normanalie/vathult3000/hardware/electronic/InputBoard/BlocDiagram_Input.png

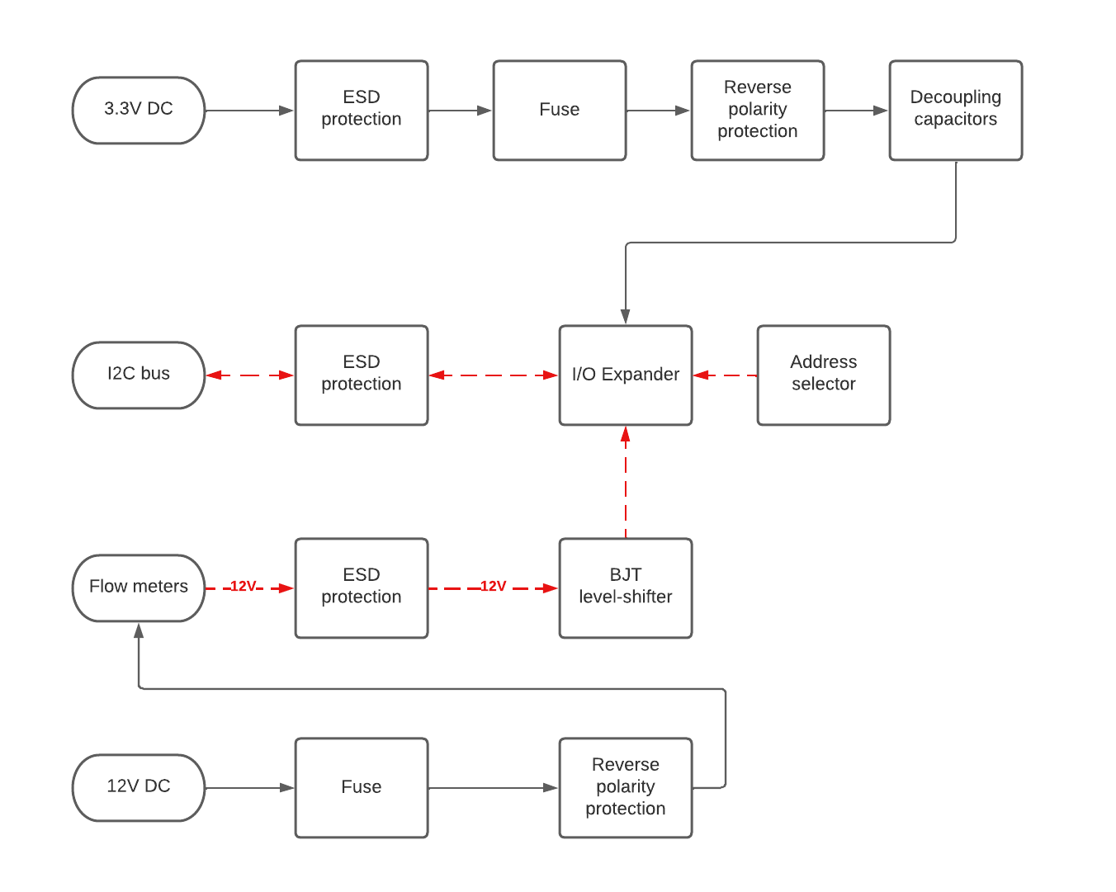
hardware/electronic/InputBoard/BlocDiagram_Input.png
