normanalie/vathult3000/hardware/electronic/InputBoard/render_2D.PNG

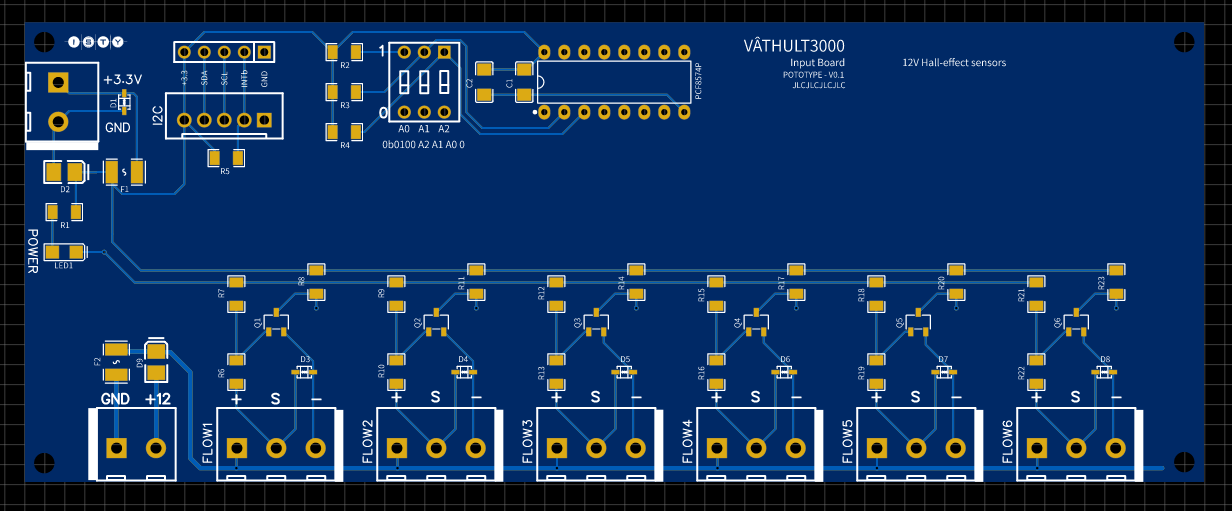
hardware/electronic/InputBoard/render_2D.PNG
