normanalie/vathult3000/hardware/electronic/InputBoard/render_3D.PNG

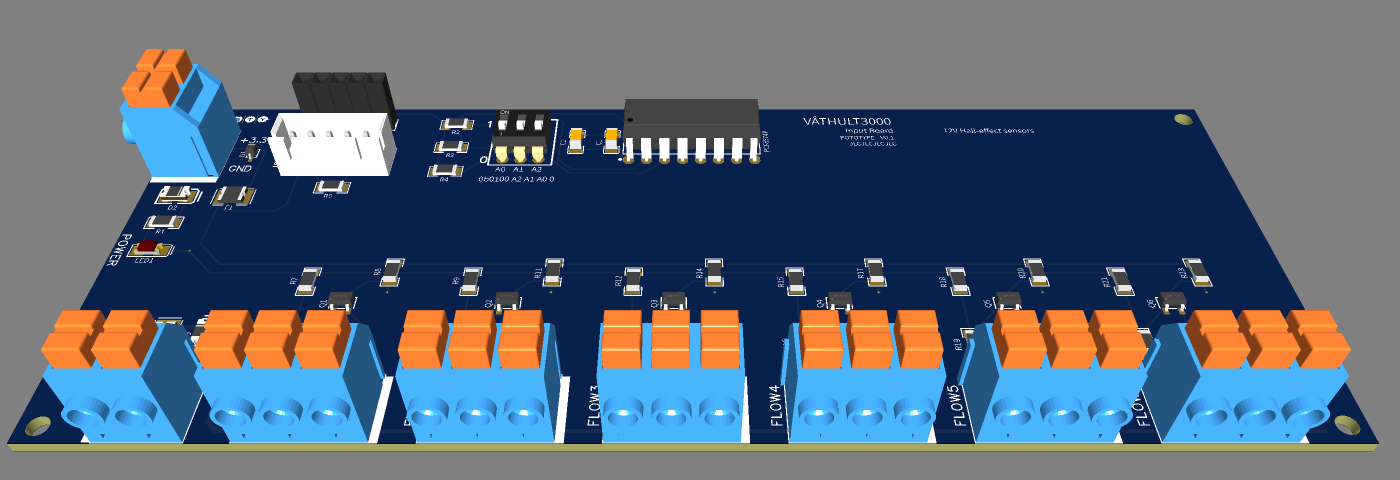
hardware/electronic/InputBoard/render_3D.PNG
