normanalie/vathult3000/hardware/electronic/InterfaceBoard/BlocDiagram_Interface.png

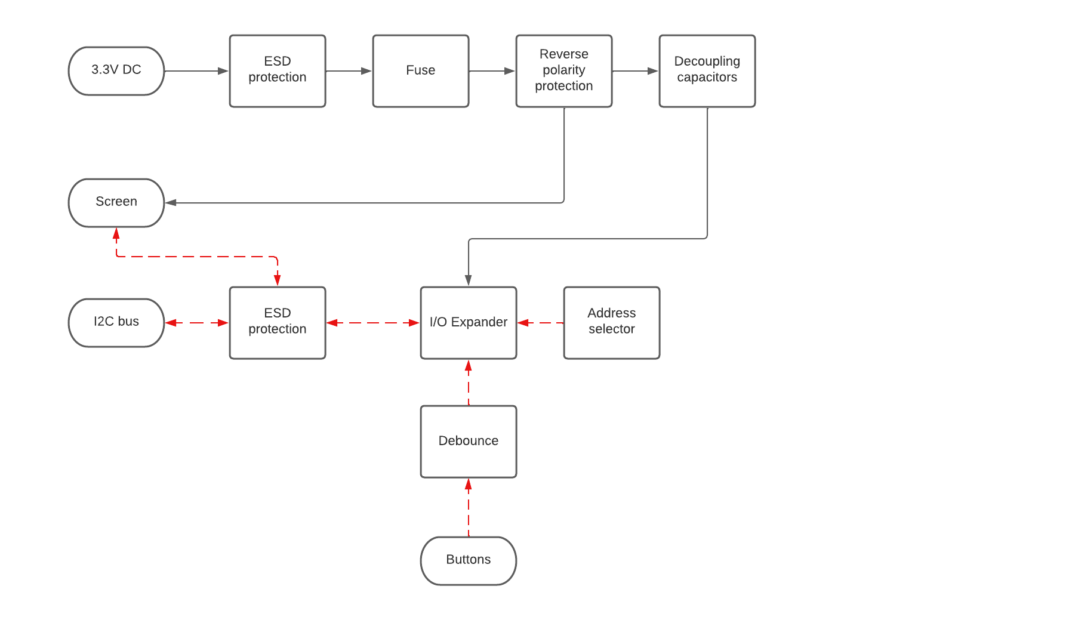
hardware/electronic/InterfaceBoard/BlocDiagram_Interface.png
