normanalie/vathult3000/hardware/electronic/InterfaceBoard/render_2D.PNG

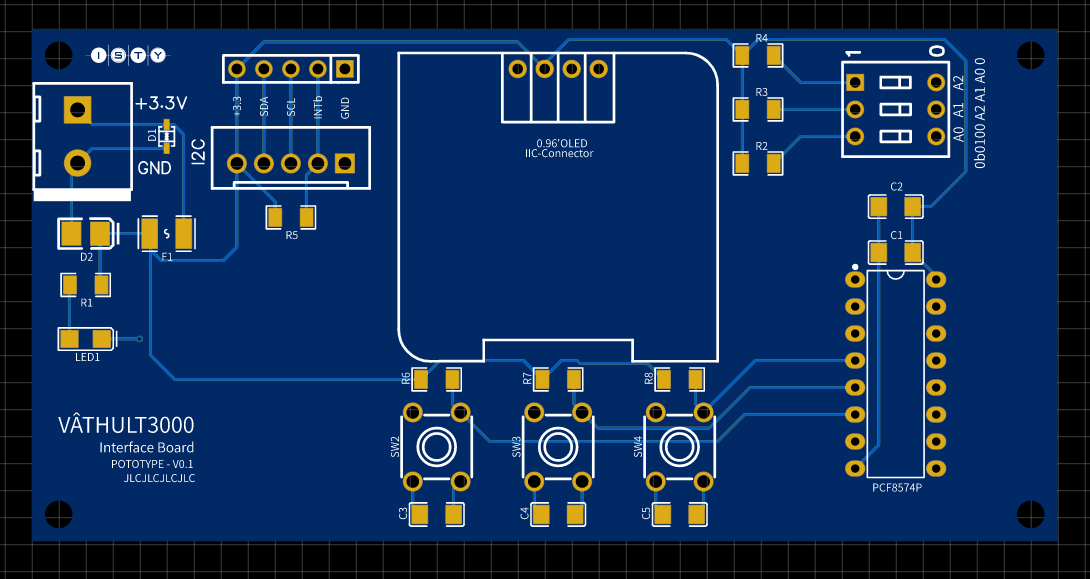
hardware/electronic/InterfaceBoard/render_2D.PNG
