normanalie/vathult3000/hardware/electronic/InterfaceBoard/render_3D.PNG

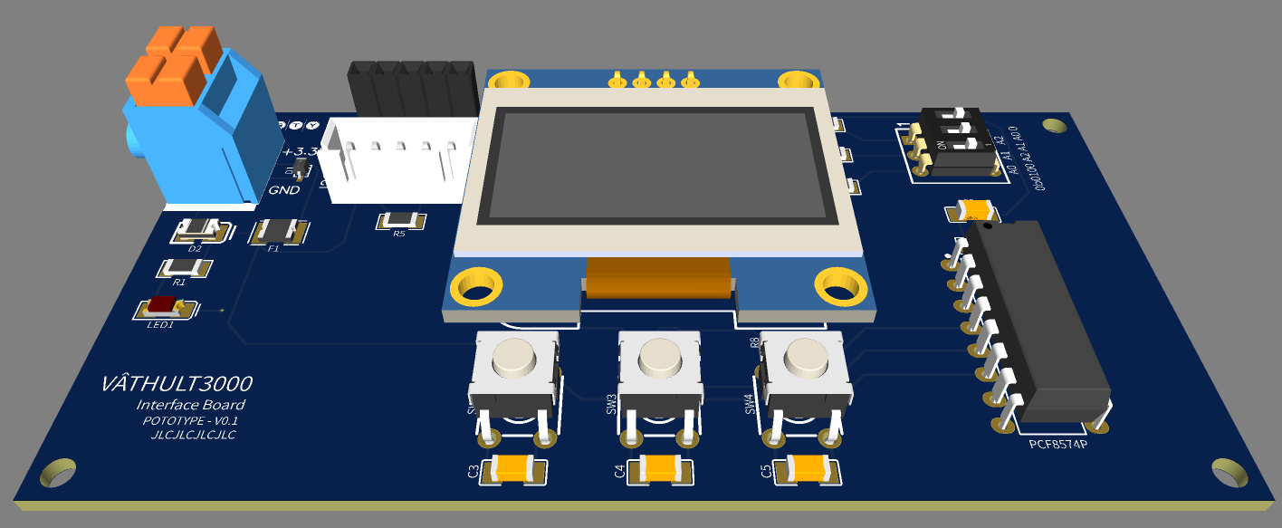
hardware/electronic/InterfaceBoard/render_3D.PNG
