normanalie/vathult3000/hardware/electronic/LogicVoltageRegulator/BlocDiagram_LogicRegulator.png

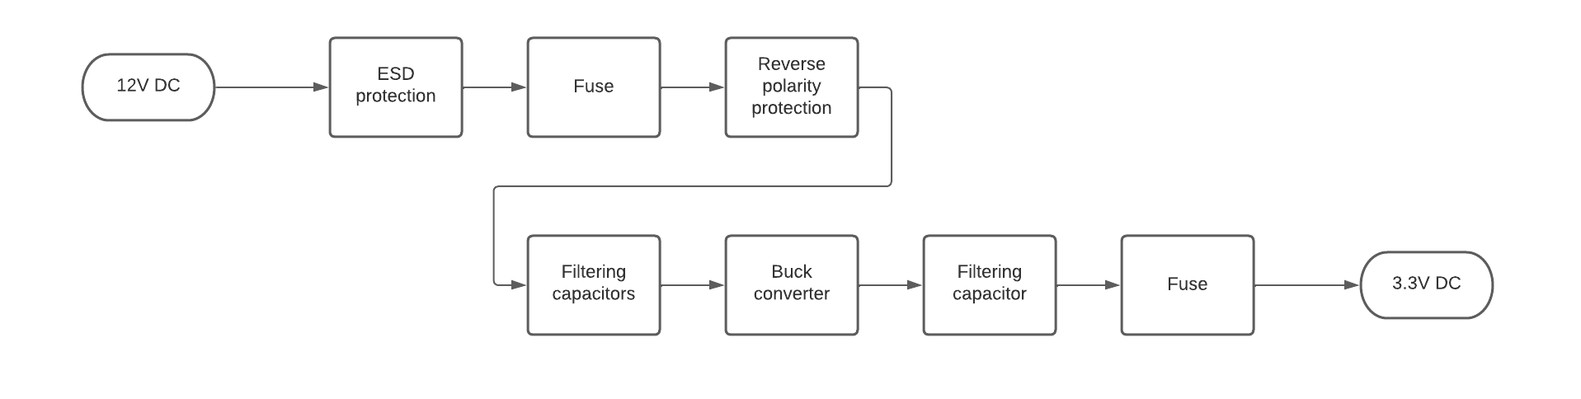
hardware/electronic/LogicVoltageRegulator/BlocDiagram_LogicRegulator.png
