normanalie/vathult3000/hardware/electronic/LogicVoltageRegulator/render_2D.PNG

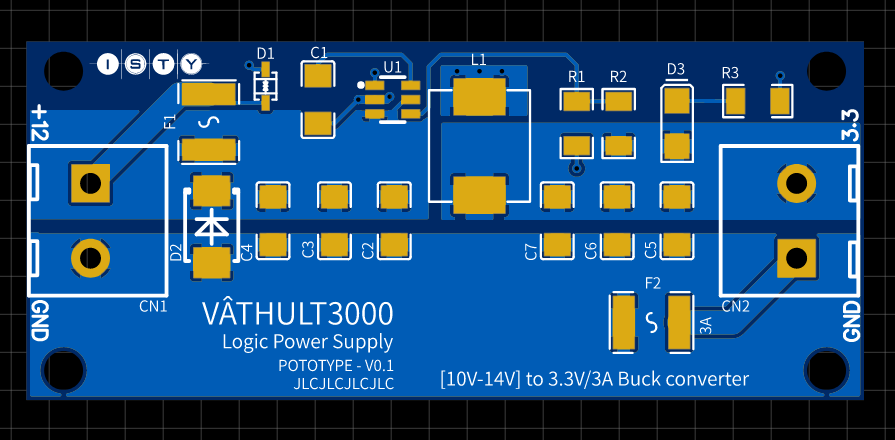
hardware/electronic/LogicVoltageRegulator/render_2D.PNG
