normanalie/vathult3000/hardware/electronic/LogicVoltageRegulator/render_3D.PNG

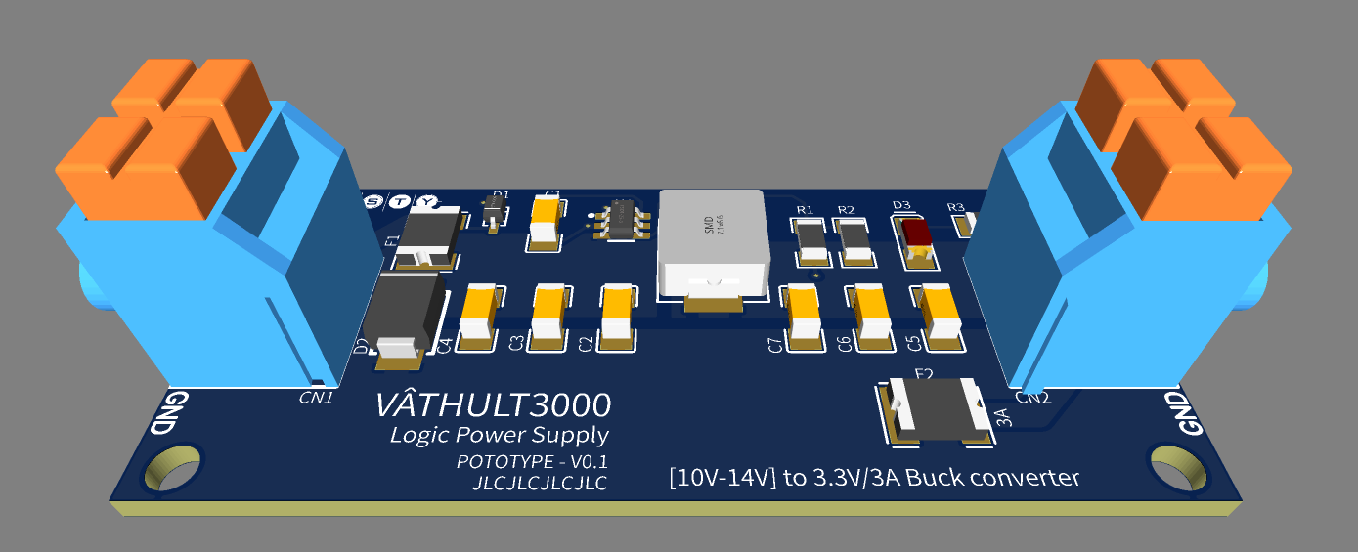
hardware/electronic/LogicVoltageRegulator/render_3D.PNG
