normanalie/vathult3000/hardware/electronic/MainBoard/BlocDiagram_Main.png

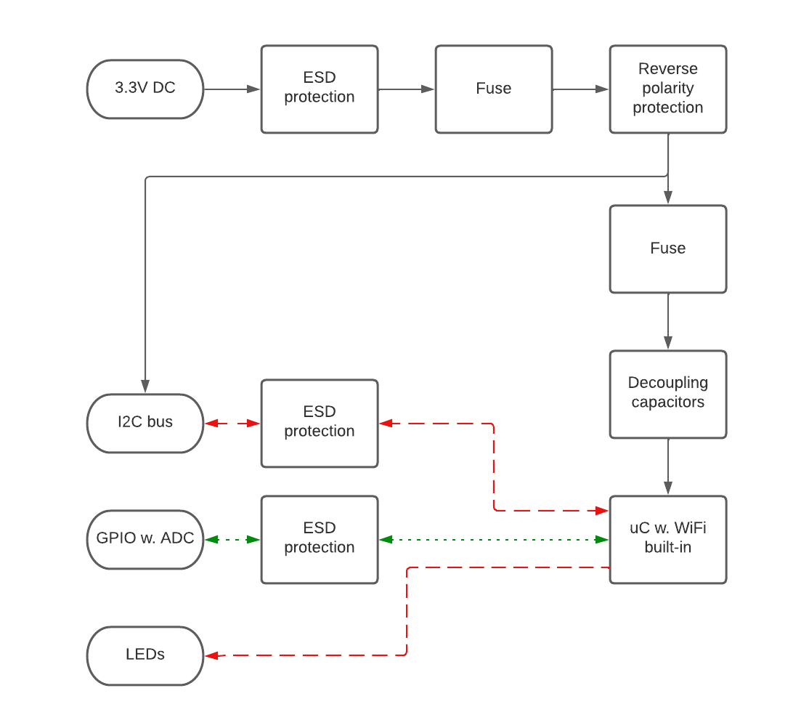
hardware/electronic/MainBoard/BlocDiagram_Main.png
