normanalie/vathult3000/hardware/electronic/MainBoard/render_2D.PNG

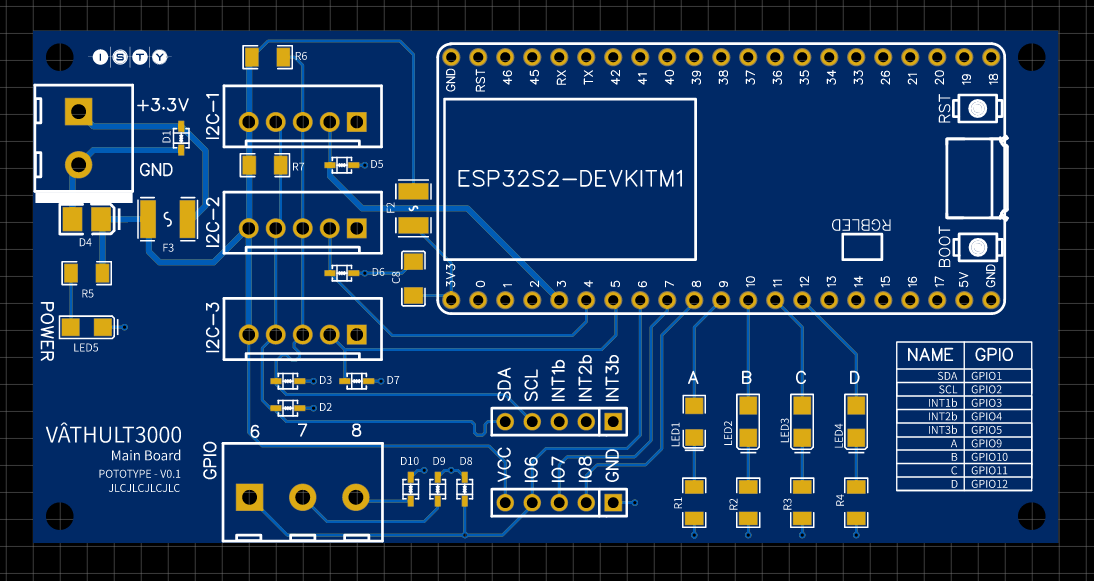
hardware/electronic/MainBoard/render_2D.PNG
