normanalie/vathult3000/hardware/electronic/MainBoard/render_3D.PNG

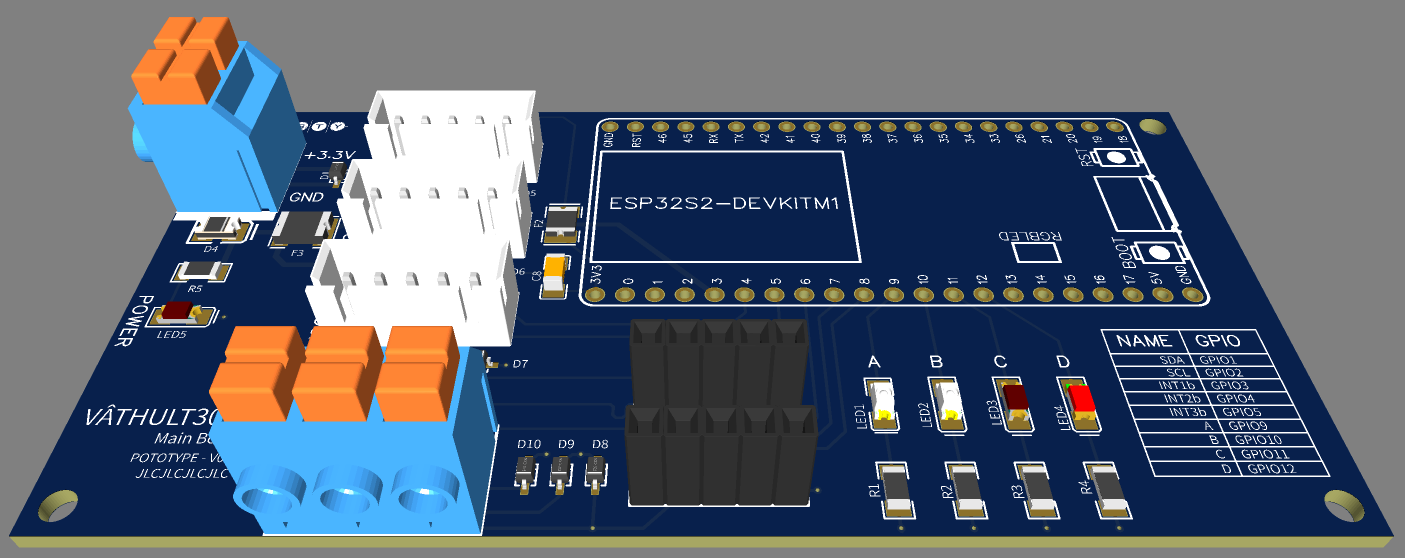
hardware/electronic/MainBoard/render_3D.PNG
