normanalie/vathult3000/hardware/electronic/OutputBoard/BlocDiagram_Output.png

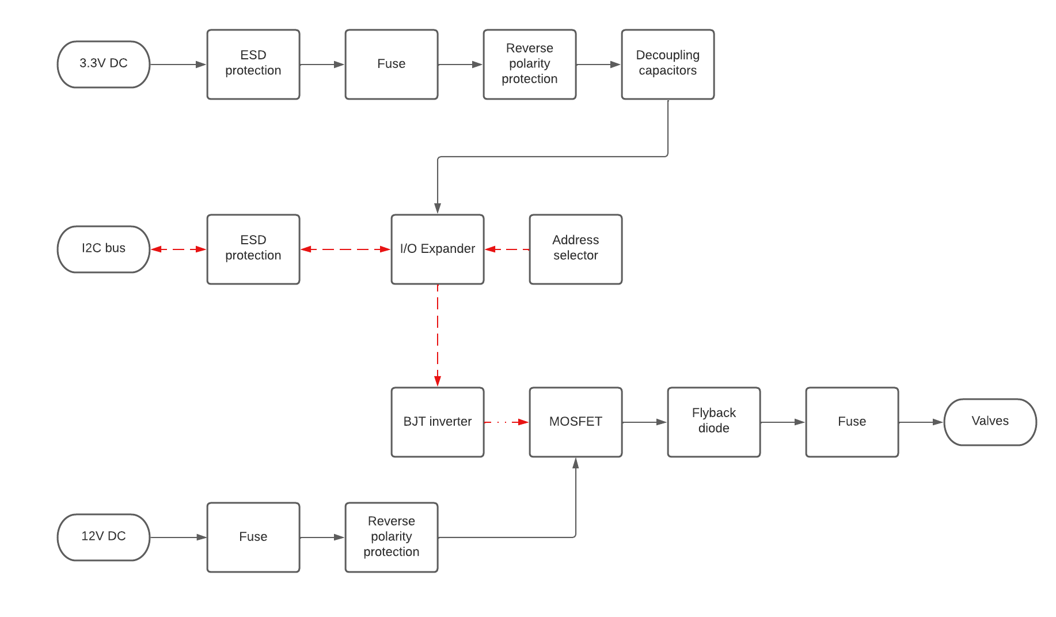
hardware/electronic/OutputBoard/BlocDiagram_Output.png
