normanalie/vathult3000/hardware/electronic/OutputBoard/render_2D.PNG

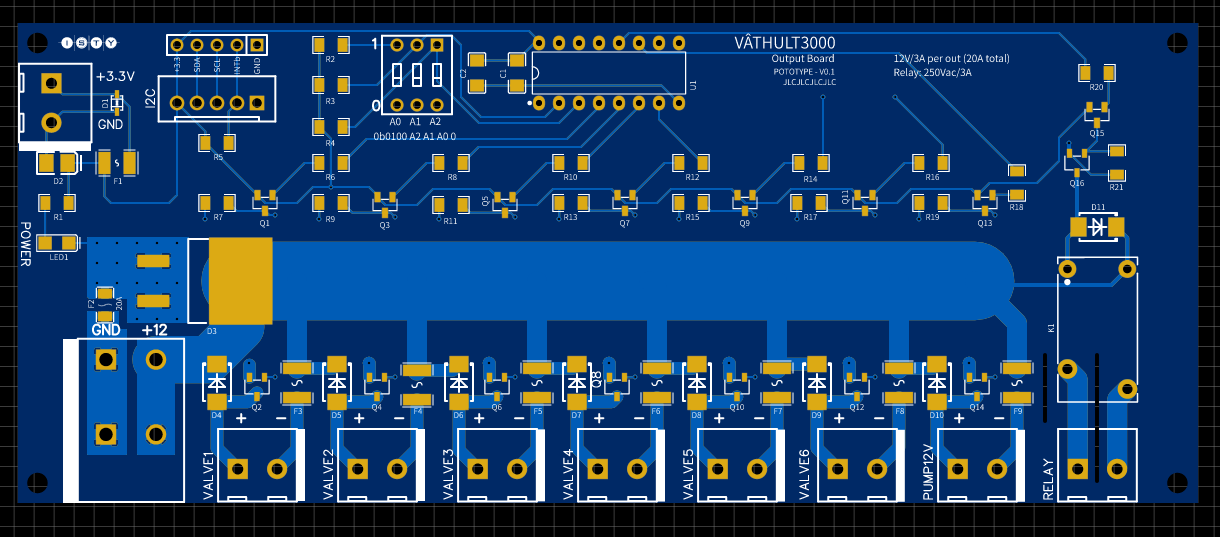
hardware/electronic/OutputBoard/render_2D.PNG
