normanalie/vathult3000/hardware/electronic/OutputBoard/render_3D.PNG

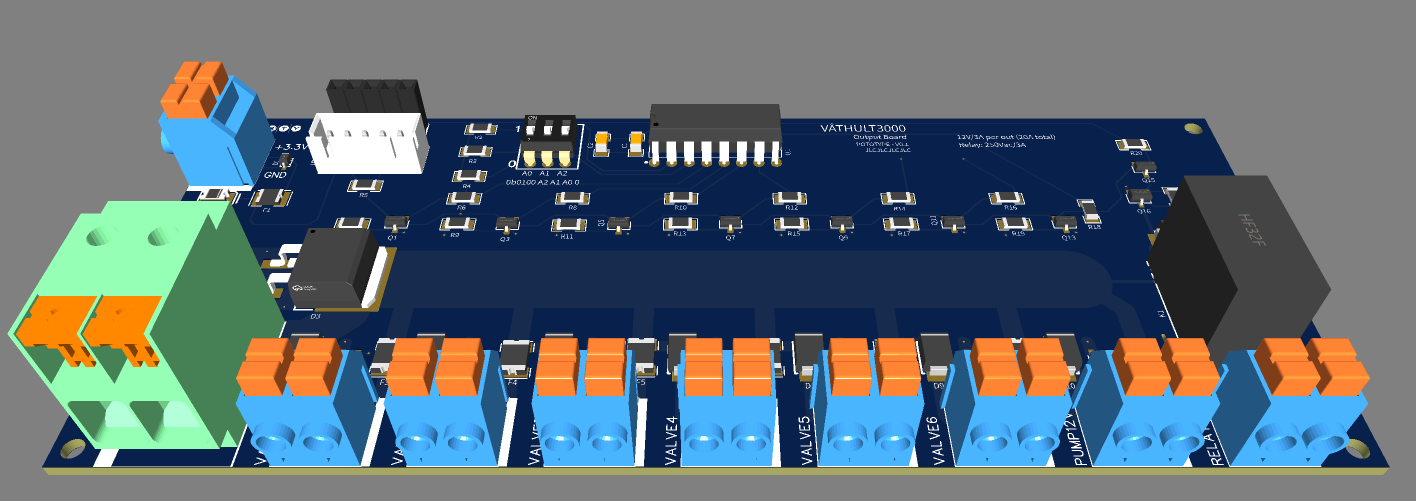
hardware/electronic/OutputBoard/render_3D.PNG
