normanalie/vathult3000/hardware/plumbing/BlocDiagram_Plumbing.png

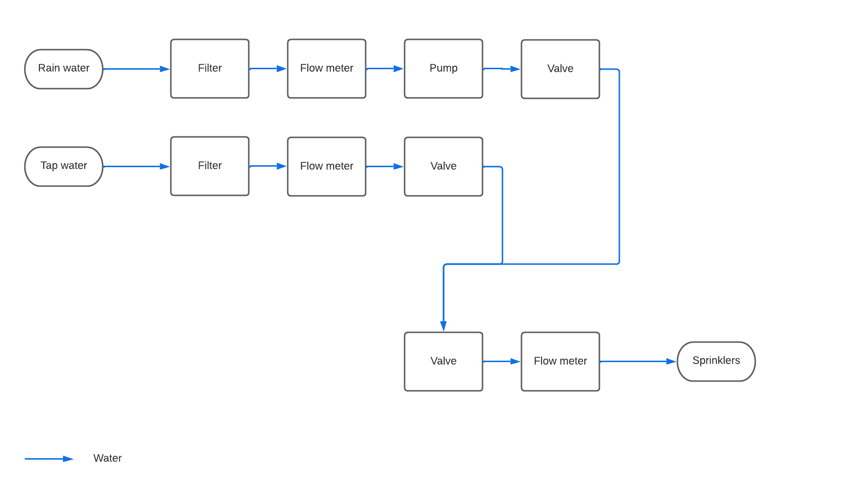
hardware/plumbing/BlocDiagram_Plumbing.png
