normanalie/vathult3000/hardware/electronic/MainBoard/MainBoard.dxf

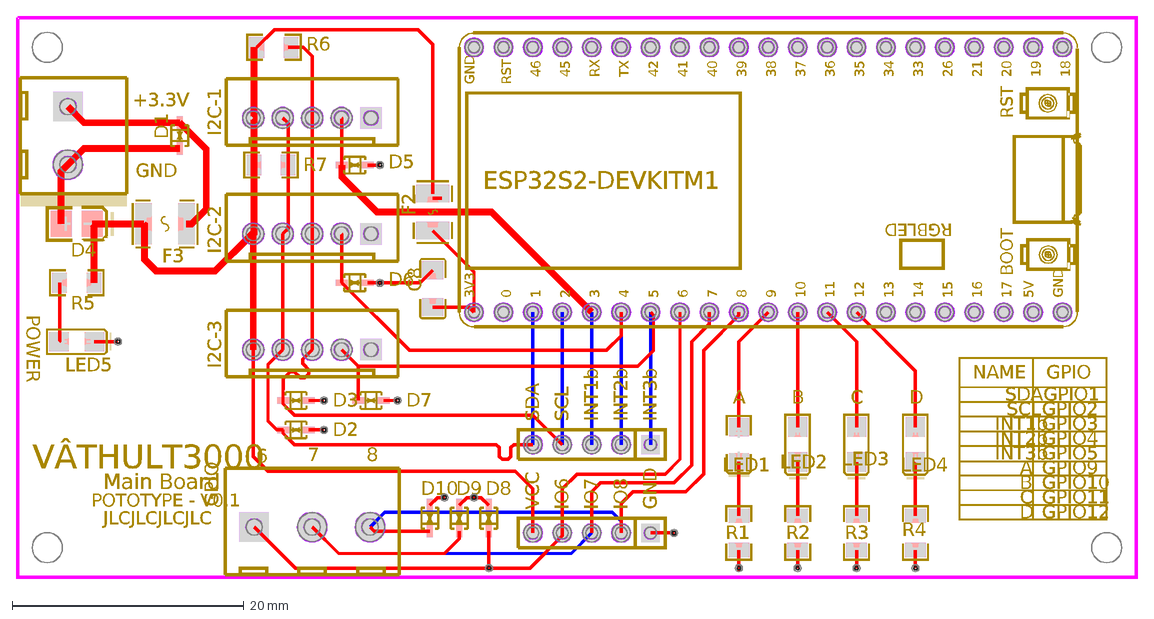
[picture p20: CAD file, 2023-03-14]
hardware/electronic/MainBoard/MainBoard.dxf
+3.3V
GND
POWER
6
7
8
SDA
SCL
INT1b
INT2b
INT3b
VCC
IO6
IO7
IO8
A
B
C
D
VÂTHULT3000
Main Board
POTOTYPE - V0.1
NAME
GPIO
GPIO1
GPIO2
GPIO3
GPIO4
GPIO5
GPIO9
GPIO10
GPIO11
GPIO12
JLCJLCJLCJLC
F2
F3
R6
R7
LED1
LED2
LED3
LED4
R1
R2
R3
R4
R5
I2C-3
ESP32S2-DEVKITM1
RST
BOOT
RGBLED
17
16
15
14
13
12
0
1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
