normanalie/vathult3000/hardware/electronic/InputBoard/InputBoard.dxf

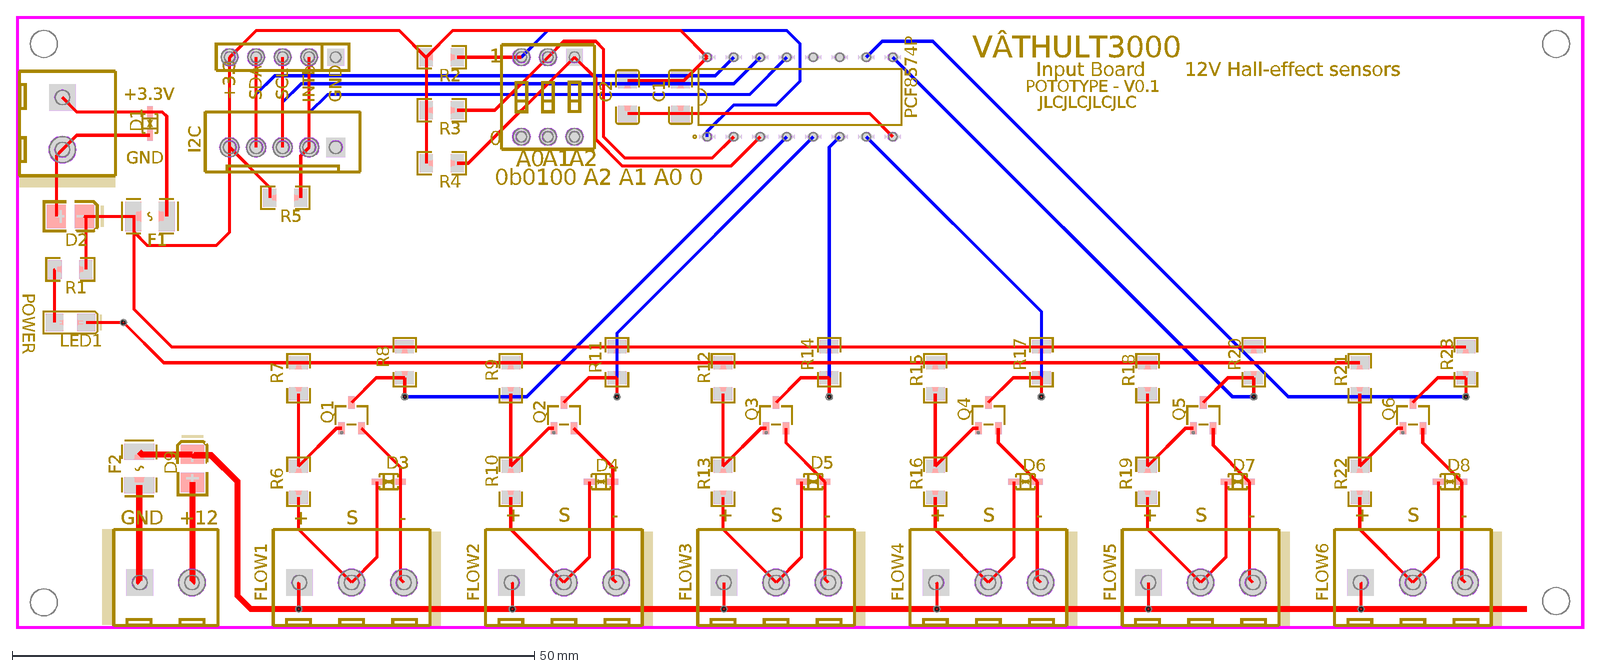
[picture p21: CAD file, 2023-03-14]
hardware/electronic/InputBoard/InputBoard.dxf
POWER
+3.3V
GND
+12
+3.3
SDA
SCL
INTb
0
1
0b0100 A2 A1 A0 0
PCF8574P
12V Hall-effect sensors
POTOTYPE - V0.1
Input Board
VÂTHULT3000
+
-
S
JLCJLCJLCJLC
C1
C2
D1
D3
D4
D5
D6
D7
D8
D2
D9
F1
F2
FLOW1
FLOW2
FLOW3
FLOW4
FLOW5
FLOW6
I2C
LED1
Q1
Q2
Q3
Q4
Q5
Q6
R1
R2
R3
R4
R5
R6
R7
R8
R9
R10
R11
R12
R13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
