normanalie/vathult3000/hardware/electronic/InterfaceBoard/InterfaceBoard.dxf

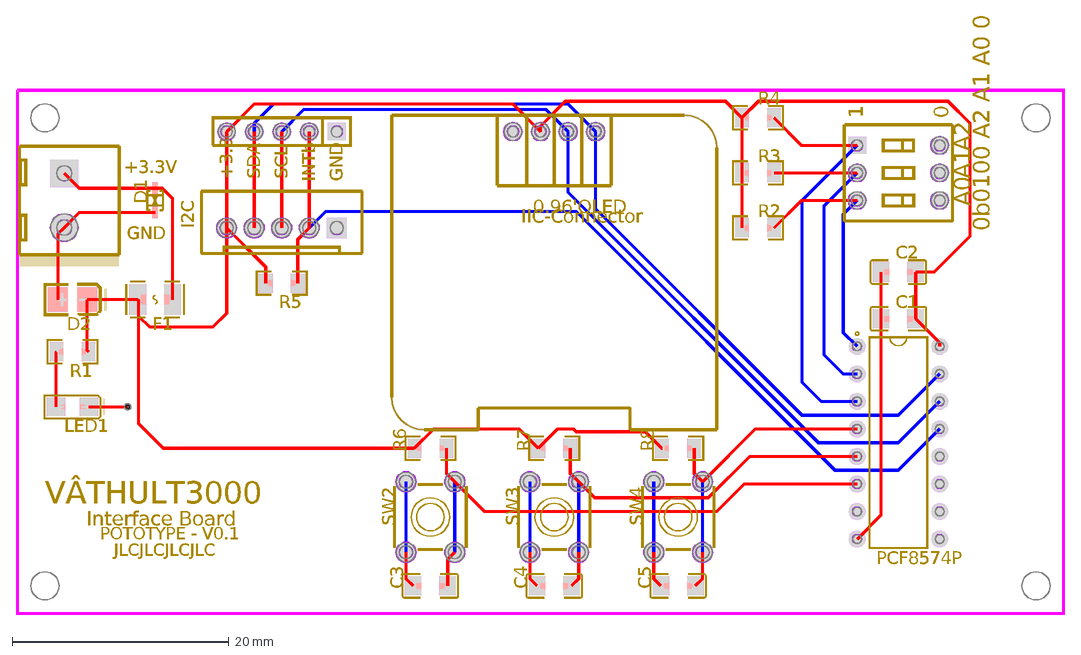
[picture p22: CAD file, 2023-03-14]
hardware/electronic/InterfaceBoard/InterfaceBoard.dxf
+3.3V
GND
PCF8574P
1
0
0b0100 A2 A1 A0 0
VÂTHULT3000
Interface Board
POTOTYPE - V0.1
+3.3
SDA
SCL
INTb
JLCJLCJLCJLC
C1
C2
D1
D2
F1
I2C
LED1
IIC-Connector
0.96'OLED
R1
R2
R3
R4
R5
A0
A1
A2
C4
SW3
C3
C5
R6
R7
R8
SW2
SW4
