normanalie/vathult3000/hardware/electronic/LogicVoltageRegulator/LogicVoltageRegulator.dxf

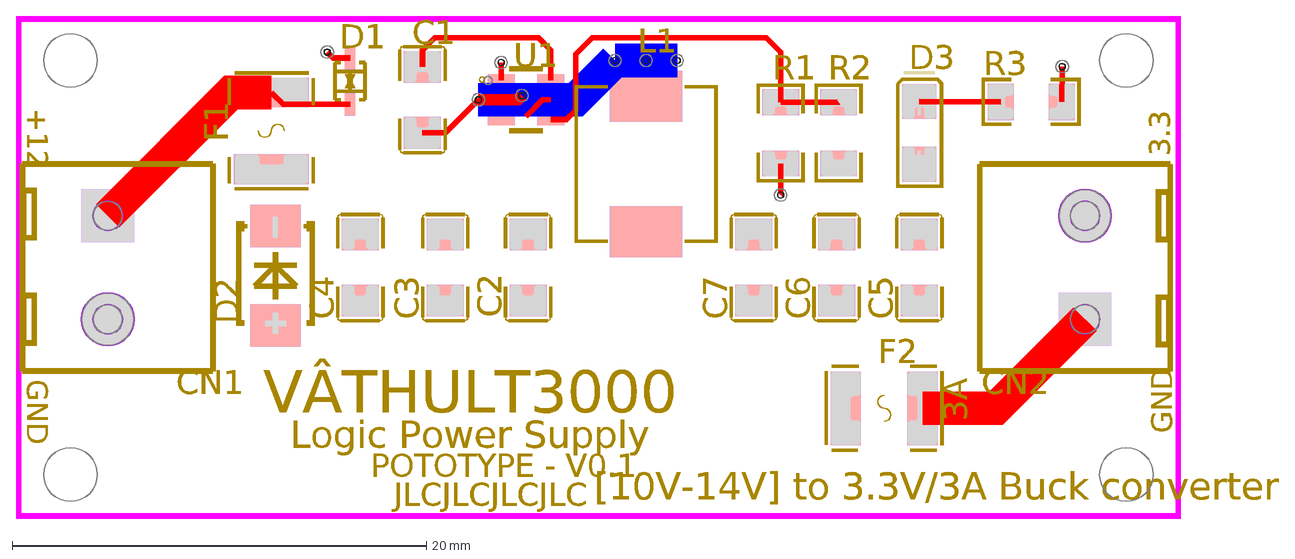
[picture p23: CAD file, 2023-03-14]
hardware/electronic/LogicVoltageRegulator/LogicVoltageRegulator.dxf
VÂTHULT3000
Logic Power Supply
POTOTYPE - V0.1
[10V-14V] to 3.3V/3A Buck converter
GND
+12
3.3
3A
JLCJLCJLCJLC
D2
F1
F2
D1
D3
CN1
R3
CN2
C1
C2
C3
C4
C5
C6
C7
L1
R1
R2
U1
