normanalie/vathult3000/hardware/electronic/OutputBoard/OutputBoard.dxf

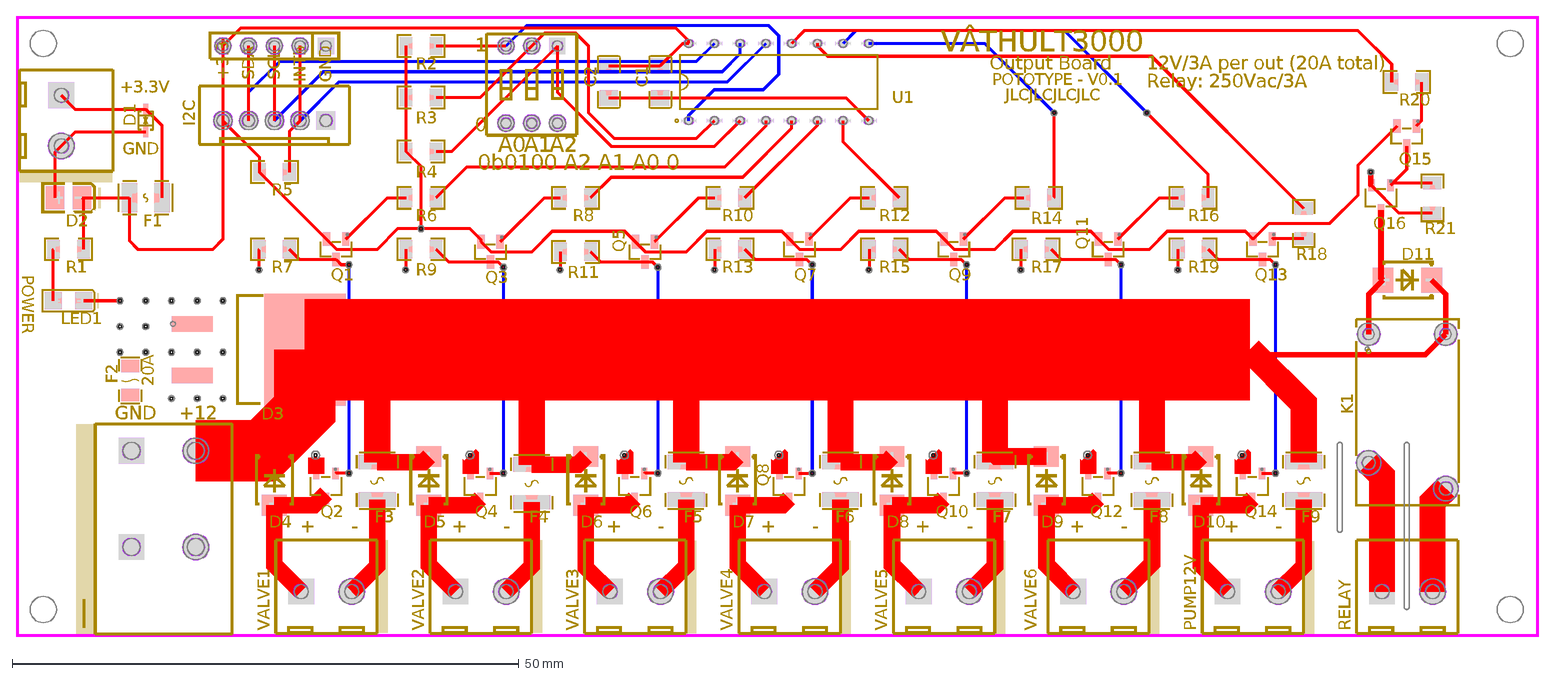
[picture p24: CAD file, 2023-03-14]
hardware/electronic/OutputBoard/OutputBoard.dxf
POWER
20A
+3.3V
GND
+12
+
-
+3.3
SDA
SCL
INTb
1
0
0b0100 A2 A1 A0 0
POTOTYPE - V0.1
Output Board
VÂTHULT3000
12V/3A per out (20A total)
Relay: 250Vac/3A
JLCJLCJLCJLC
RELAY
U1
F2
C1
C2
D1
D2
D3
D4
D5
D6
D7
D8
D9
D10
D11
F1
I2C
LED1
PUMP12V
VALVE1
VALVE2
VALVE3
VALVE4
VALVE5
VALVE6
Q1
Q3
Q5
Q7
Q9
Q11
Q13
Q15
Q2
Q4
Q6
Q8
Q10
Q12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
