normanalie/vathult3000/hardware/electronic/PCB_V3K-V1_2023-03-14 (1).dxf

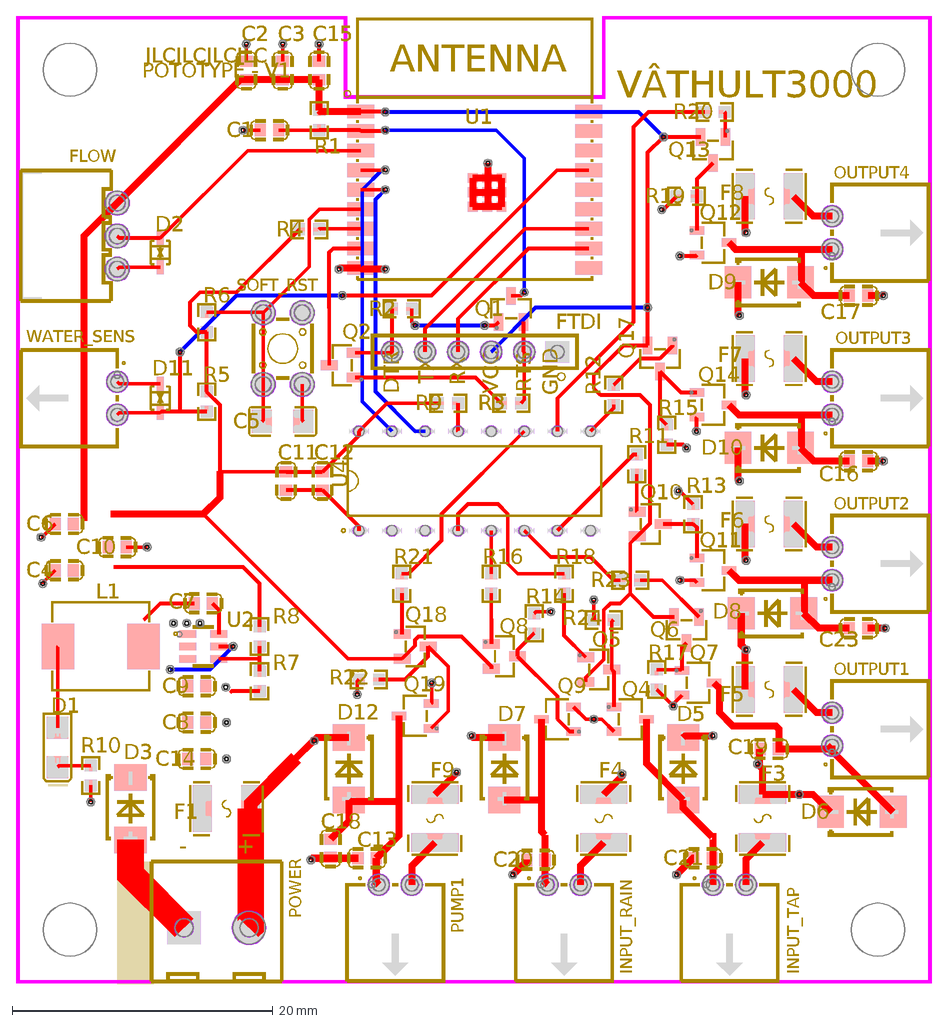
[picture p25: CAD file, 2023-10-30]
hardware/electronic/PCB_V3K-V1_2023-03-14 (1).dxf
DTR
TX
RX
VCC
RTS
GND
+
-
POTOTYPE - V1
VÂTHULT3000
JLCJLCJLCJLC
C13
C16
C17
C18
C19
C20
C21
C23
INPUT_RAIN
INPUT_TAP
OUTPUT1
OUTPUT2
OUTPUT3
OUTPUT4
POWER
PUMP1
SOFT_RST
C1
C2
C3
C4
C5
C6
C7
C8
C9
C10
C11
C12
C14
C15
D1
D2
D3
D5
D6
D7
D8
D9
D10
D11
D12
F1
F3
F4
F5
F6
F7
F8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
