normanalie/vathult3000/hardware/electronic/3D_PCB_PCB_V3K-V1_2023-03-14_2023-03-14.step

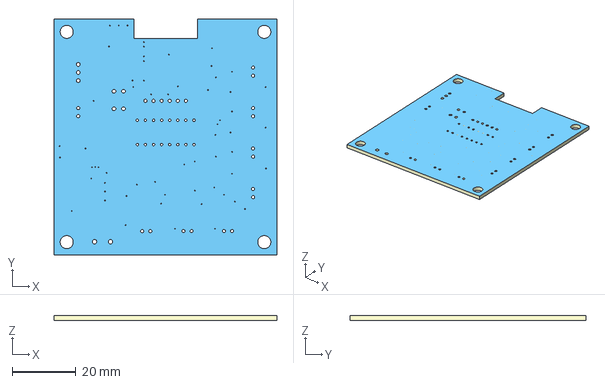
[picture p26: CAD file, 2023-10-30]
hardware/electronic/3D_PCB_PCB_V3K-V1_2023-03-14_2023-03-14.step
70.0 x 74.0 x 1.60 mm
