normanalie/vathult3000/hardware/electronic/Schematic_V3K-V1_2023-03-25.pdf

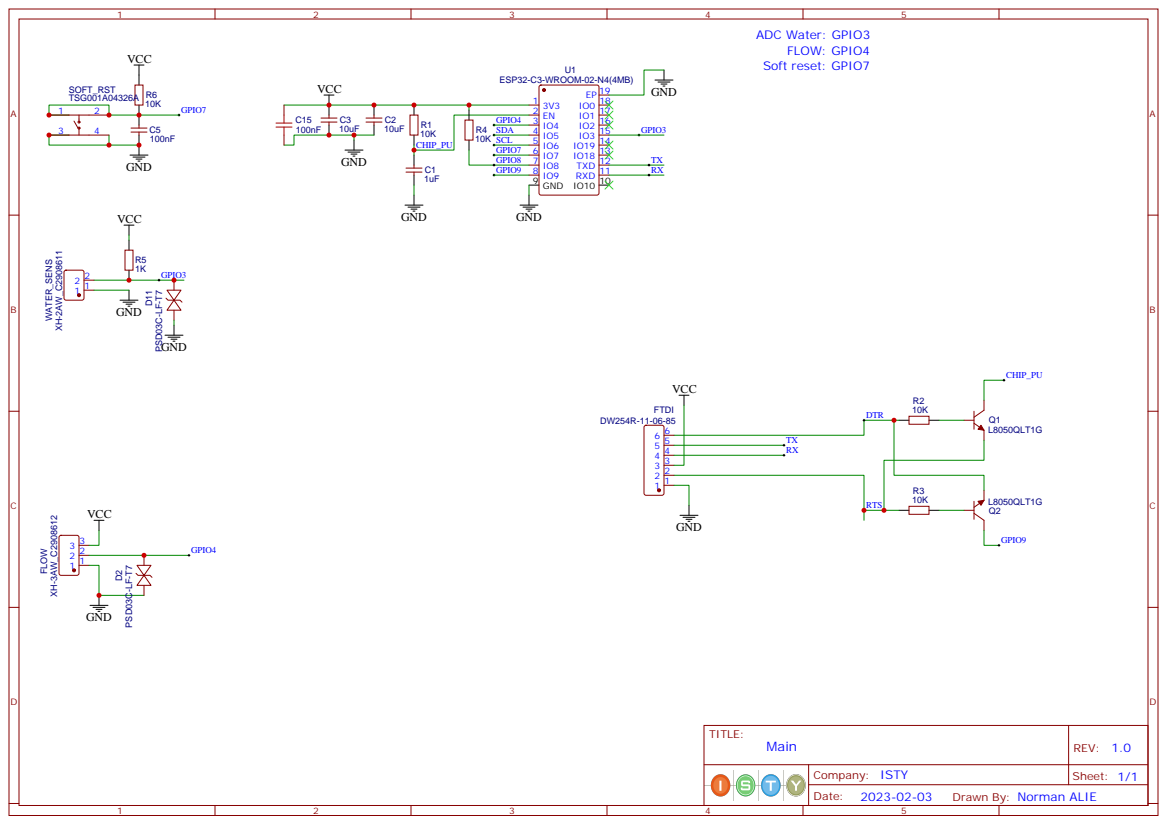
[picture p27: page 1]

Drawn By: Norman ALIE

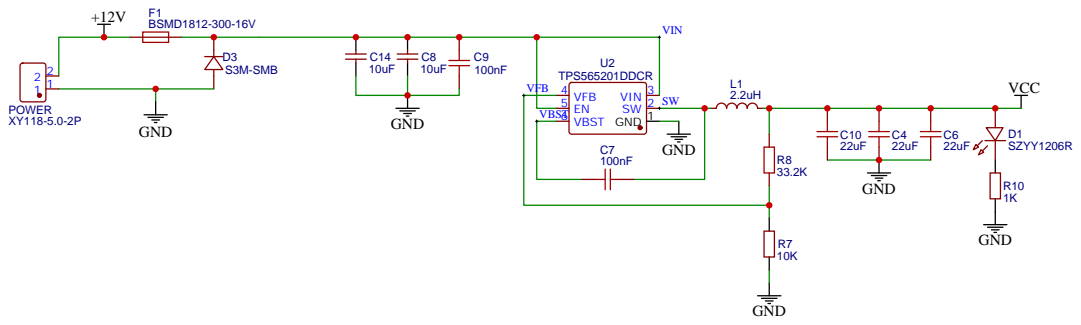
[picture p28: page 2]

# GND BC⁸⁵⁶B_C⁴⁶⁶⁶⁴⁸

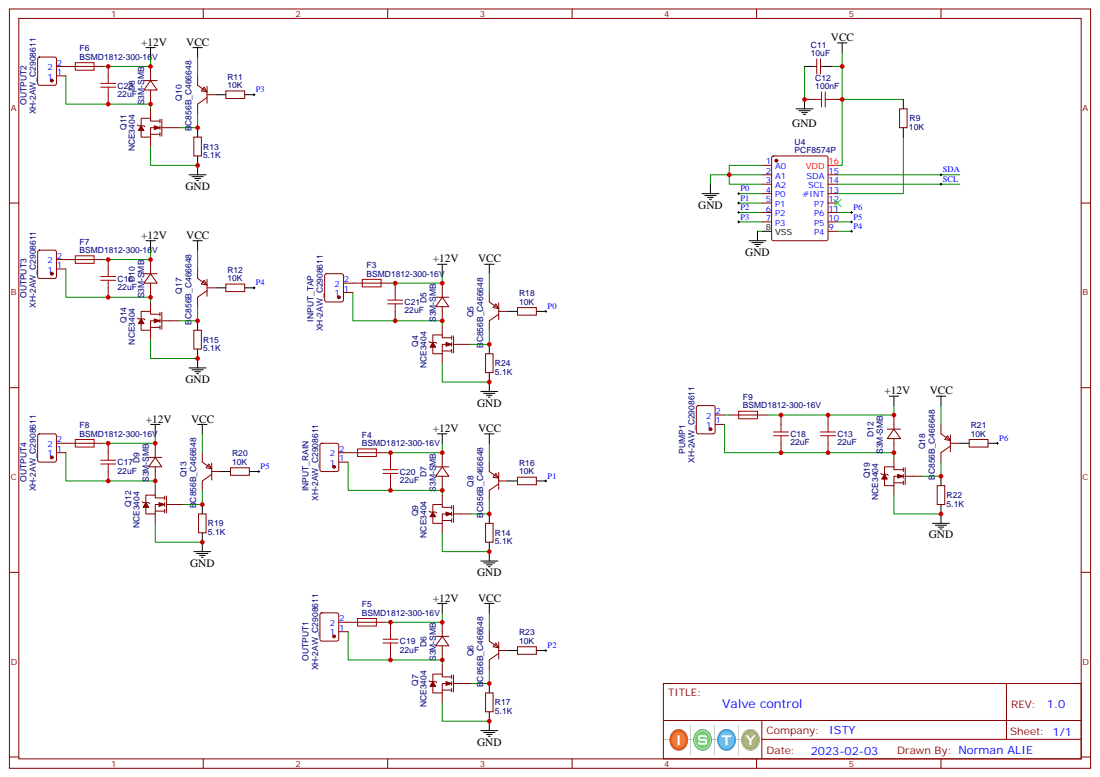
[picture p29: page 3]

P5 10 P6 11 P7 12 #INT 13 SCL 14 SDA 15 VDD 16
