normanalie/vathult3000/hardware/electronic/InputBoard/Schematic_InputBoard.pdf

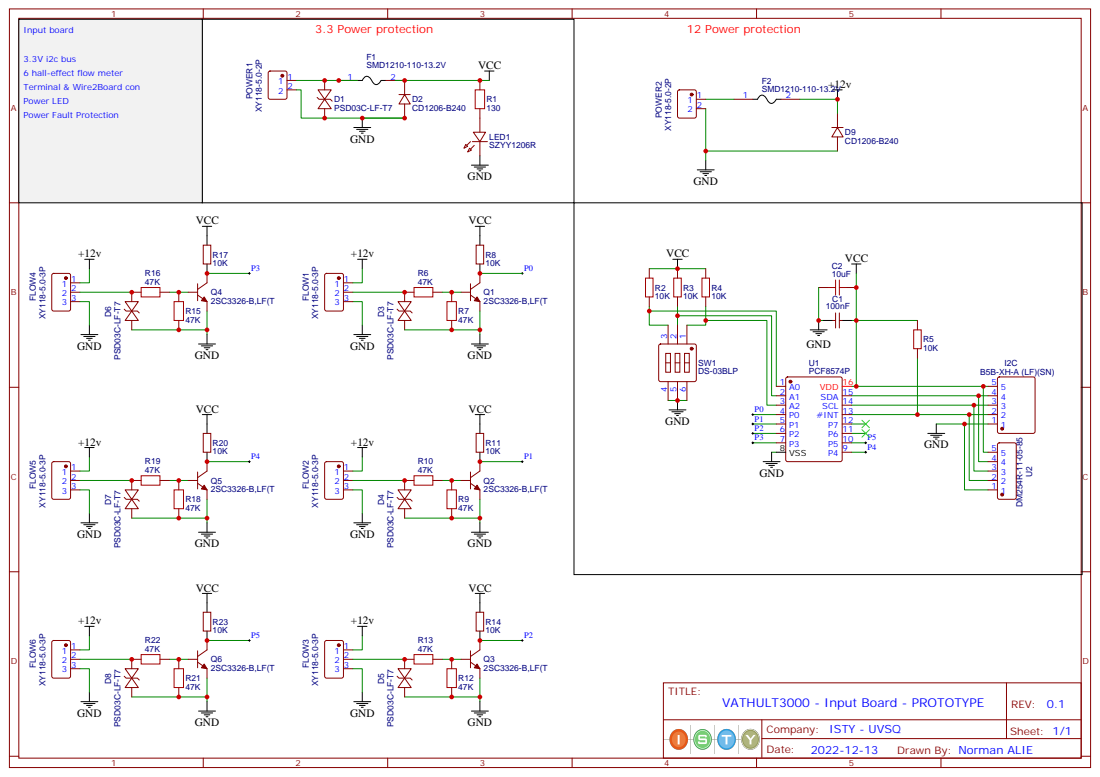
[picture p30: page 1]

3.3V i2c bus
6 hall-effect flow meter
Terminal & Wire2Board con
Power LED
Power Fault Protection

P5 10 P6 11 P7 12 #INT 13 SCL 14 SDA 15 VDD 16

Drawn By: Norman ALIE
