normanalie/vathult3000/hardware/electronic/MainBoard/Schematic_MainBoard.pdf

## Power protection

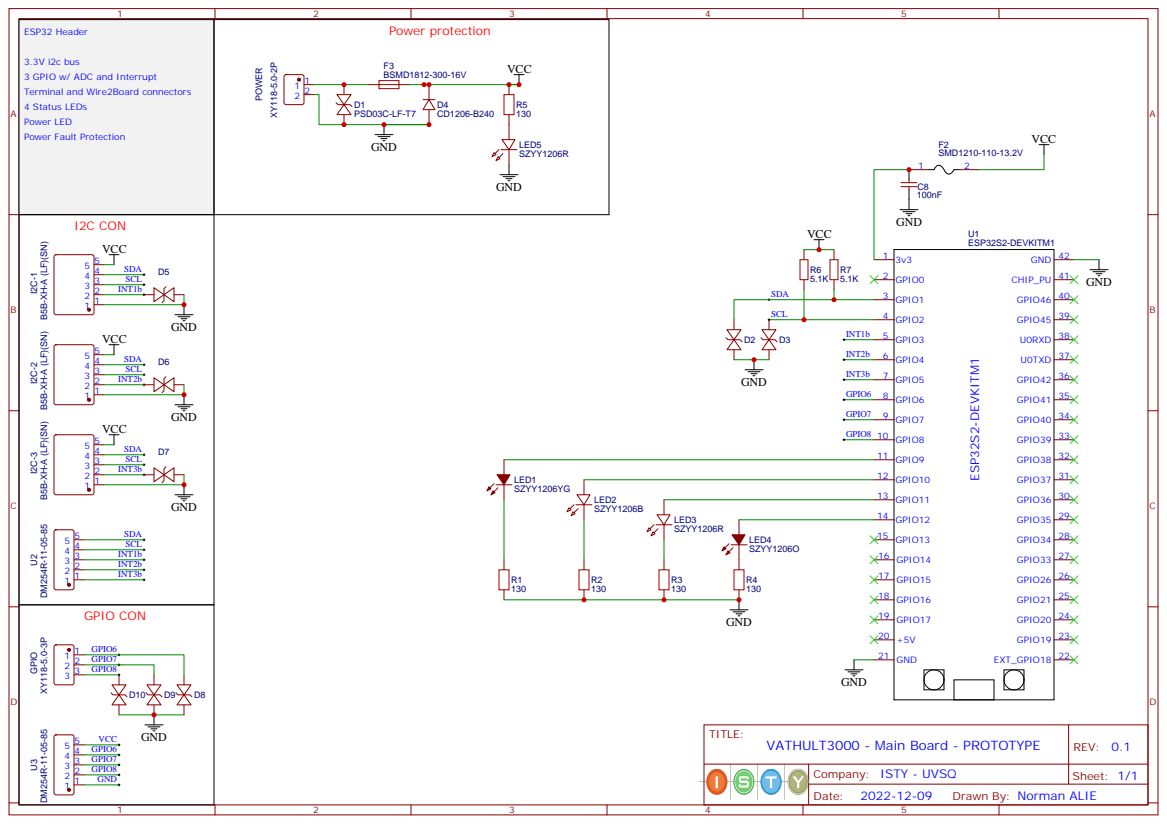
[picture p31: page 1]

3.3V i2c bus
3 GPIO w/ ADC and Interrupt
Terminal and Wire2Board connectors
4 Status LEDs
Power LED
Power Fault Protection

Drawn By: Norman ALIE
