normanalie/vathult3000/hardware/electronic/LogicVoltageRegulator/Schematic_LogicVoltageRegulator.pdf

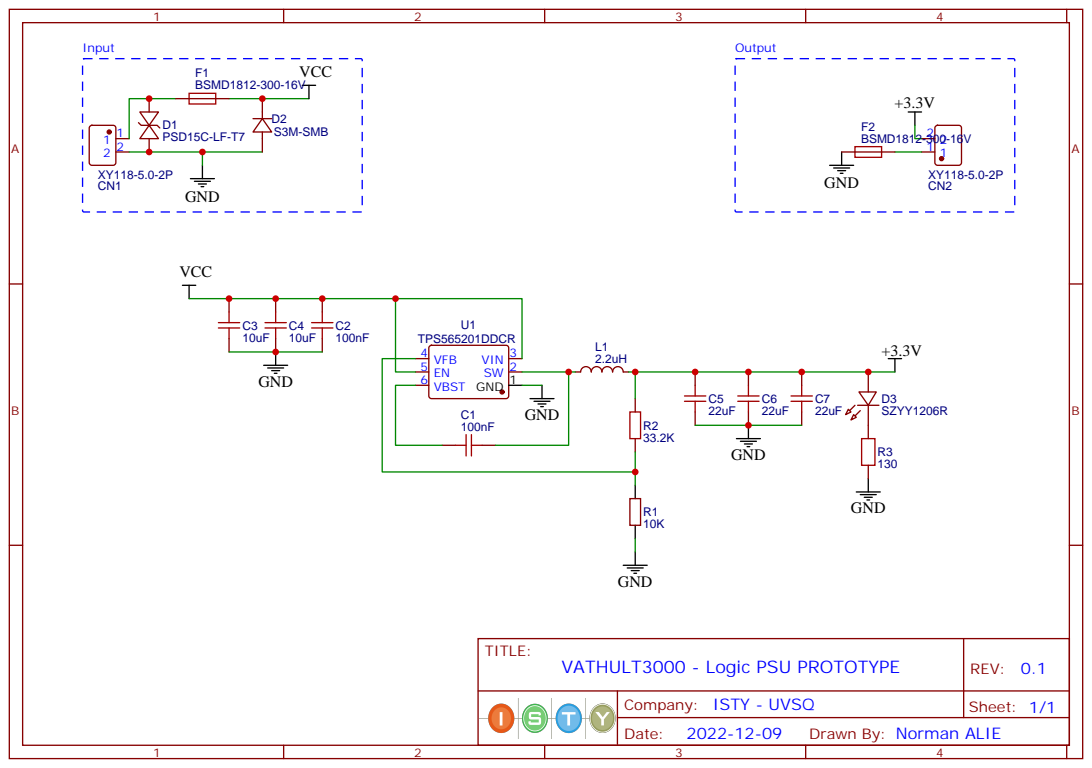
[picture p32: page 1]

Drawn By: Norman ALIE
