normanalie/vathult3000/hardware/electronic/OutputBoard/Schematic_OutputBoard.pdf

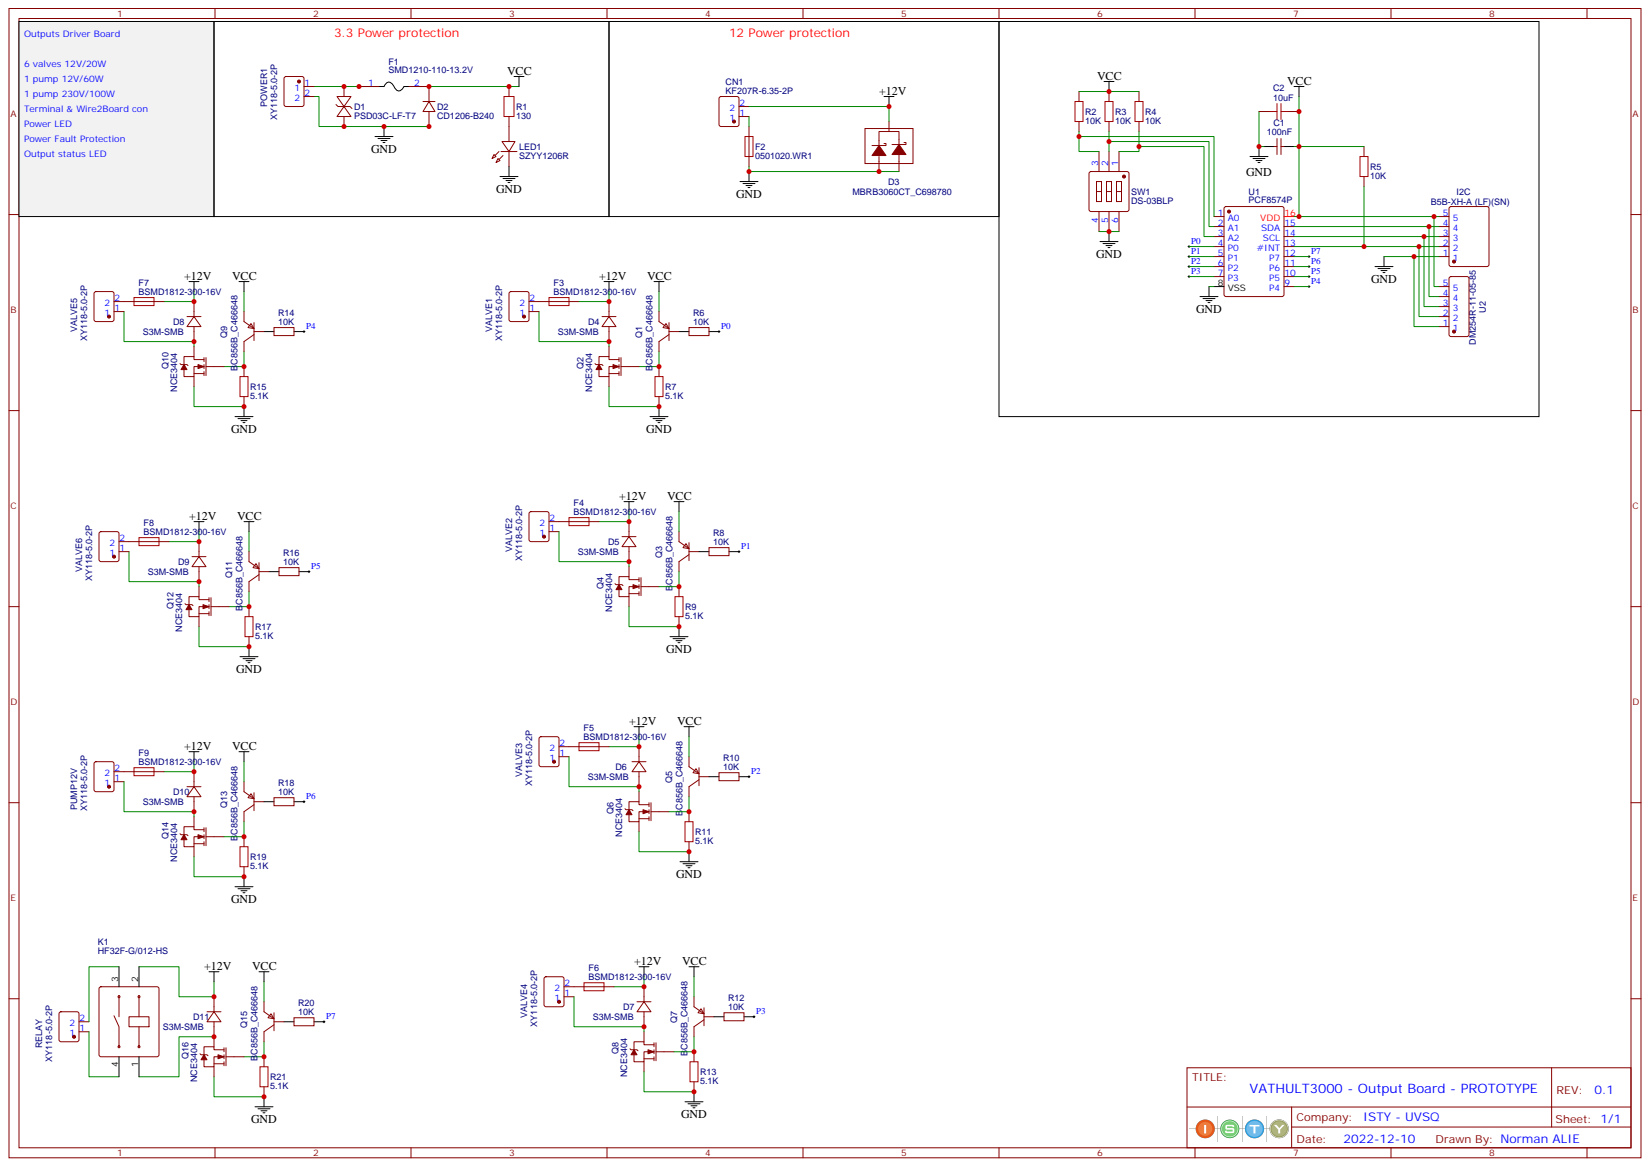
[picture p33: page 1]

Drawn By: Norman ALIE
