normanalie/vathult3000/firmware/bitmaps.h

#ifndef BITMAPS_H
#define BITMAPS_H

/* Graphic library of bitmap icon used by the Screen interface */

//#define PROGMEM ICACHE_RODATA_ATTR


// All the arrays below are generated from images using image2cpp website

// 'icon_wifi', 11x11px
const size_t len_icon_wifi = 22;
const unsigned char bitmap_icon_wifi []  = {
	0x00, 0x00, 0x3f, 0x80, 0x7f, 0xc0, 0xc0, 0x60, 0x9f, 0x20, 0x3f, 0x80, 0x60, 0xc0, 0x4e, 0x40, 
	0x1f, 0x00, 0x11, 0x00, 0x04, 0x00
};
// 'icon_dashboard', 11x11px
const unsigned char bitmap_icon_dashboard []  = {
	0x40, 0x20, 0x40, 0x20, 0x40, 0x40, 0x40, 0x40, 0x44, 0x40, 0x4a, 0x80, 0x4a, 0x80, 0x51, 0x00, 
	0x40, 0x00, 0xff, 0xe0, 0x40, 0x00
};
// 'icon_flow_meters', 11x11px
const unsigned char bitmap_icon_flow_meters []  = {
	0x3f, 0x80, 0x44, 0x40, 0xa0, 0xa0, 0x90, 0x20, 0x88, 0x20, 0xc4, 0x60, 0x80, 0x20, 0x80, 0x20, 
	0xa0, 0xa0, 0x44, 0x40, 0x3f, 0x80
};
// 'icon_settings', 11x11px
const unsigned char bitmap_icon_settings []  = {
	0x01, 0x80, 0x03, 0x00, 0x03, 0x20, 0x03, 0xe0, 0x07, 0xc0, 0x0e, 0x00, 0x1c, 0x00, 0x38, 0x00, 
	0x70, 0x00, 0xe0, 0x00, 0xc0, 0x00
};
// 'icon_valves', 11x11px
const unsigned char bitmap_icon_valves [] = {
	0x00, 0xe0, 0x00, 0xe0, 0x01, 0xe0, 0x01, 0xc0, 0x03, 0xc0, 0x03, 0x80, 0x0f, 0x80, 0x11, 0x00, 
	0x15, 0x00, 0xff, 0xe0, 0xff, 0xe0
};


// 'wifi', 10x10px
const size_t size_wifi = 10;
const unsigned char bmp_wifi[] PROGMEM=
{
0x00,0xfc,0x80,0xfd,0x80,0xfd,0x80,0xfd,0xb0,0xfd,0xb0,0xfd,
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
	0x1f, 0xff, 0xff, 0xff, 0xff, 0xff, 0xff, 0xff, 0xff, 0xff, 0xff, 0xff, 0xff, 0xff, 0xff, 0xc0
};


/* ------------------ End generated bitmaps from image2cpp --------------------------------- */

#endif
