normanalie/vathult3000/firmware/flows.cpp

#include "esp32-hal.h"
#include "flows.h"

unsigned long first_t;
unsigned long second_t;
unsigned long flow_pulse_counter;

void IRAM_ATTR pulse_ISR(){
  flow_pulse_counter++;
}

Flows::Flows(uint8_t pin) {
  this->pin = pin;
  this->calibration_factor = CAIBRATION_FACTOR;
}

uint8_t Flows::read_L_per_min(uint8_t pin, uint8_t timeout_ms){
  // Reset pulse counter
  // Attach interrupt
  // Wait until pulsecounter reach threshold value or timeout
  // Detach interrupt
  // Calc flow rate
  flow_pulse_counter = 0;
  unsigned long start_t = millis();
  attachInterrupt(this->pin, pulse_ISR, FALLING);
  while(flow_pulse_counter < 250 && (millis() - start_t) < timeout_ms){
    //WAIT...
  } 
  unsigned long end_t = millis();
  detachInterrupt(this->pin);
  return ((1000.0 / (end_t - start_t)) * flow_pulse_counter) / this->calibration_factor;
}
