normanalie/vathult3000/(commit log)

2022-12-15 V0.1 PCBs 3D models
    [InputBoard.dxf, InterfaceBoard.dxf, LogicVoltageRegulator.dxf, MainBoard.dxf, OutputBoard.dxf]
2022-12-15 V0.1 Schematics
2022-12-15 PCBs render
2023-01-28 Fix icon stacking on screen
    [interface.cpp, interface.h]
2023-01-30 Fix err message in headbar
    [interface.cpp]
2023-01-30 Start implementing flow meters
2023-02-18 PROGMEM compiler error on esp32
    [bitmaps.h, firmware.ino]
2023-02-24 config ESP32
2023-02-26 Error message if keyboard not found
    [firmware.ino]
2023-02-27 fix #3
    Was checking the last connection result wich stay 3 (connected) after disconnection. Need to check the current status wich need to be "WL_CONNECTED"
    [firmware.ino]
2023-03-14 Init V1
    [PCB_V3K-V1_2023-03-14 (1).dxf]
2023-03-25 Flow sensor
